katsuhaa/racechrono-diy-esp32/(commit log)

2026-09-05 Added Abarth 595 build manual (Japanese, Rev.1.6) under docs/
    Adds the step-by-step build manual for the Abarth 595 Series 4 variant of this adapter: Freenove ESP32-WROOM-32E board, SN65HVD230 transceiver with TXD left open (receive-only), MP1584EN 5 V buck fed from OBD pin 16, J1962 plug, known Fiat 500 (312) CAN-ID candidates, and Arduino IDE library versions (NimBLE-Arduino 1.4.3 pinned).
    Abarth 595 Series 4 向けの製作手順書（日本語、Rev.1.6）を docs/ に追加。Freenove ESP32-WROOM-32E、SN65HVD230（TXD オープンで受信専用）、OBD 16 番ピンから給電する MP1584EN 5 V 降圧、J1962 プラグ、Fiat 500 (312) 系の既知 CAN ID 候補、Arduino IDE の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
2026-09-06 Add config.h for the Abarth 595 on a classic ESP32-WROOM board
    Receive-only configuration: RX on GPIO 4, TX_PIN 5 left unwired,
    LOG_LEVEL_DEBUG so the 10-second frame counters serve as the on-device
    receive check, default rate 2 Hz, Fiat 500 (312) candidate CAN IDs
    listed as commented cases.
    Abarth 595 / 無印 ESP32-WROOM 用の config.h を追加。
    受信専用の設定: RX は GPIO 4、TX_PIN 5 は未配線、10 秒ごとの受信件数を
    実機での受信確認に使うため LOG_LEVEL_DEBUG、既定レート 2 Hz、
    Fiat 500（312）系の候補 CAN ID をコメントアウトで記載。
    Claude-Session: https://claude.ai/cod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
2026-09-06 Update build manual to Rev.1.7 (silkscreen pin names, figures, OBDLink method)
    Chapter 5 rewritten with the pin names printed on the boards (Freenove
    4 / 5 / 3.3V / 5V / GND), new figures for the Freenove pinout, the J1962
    plug and the wiring, a 9-wire table including MP1584EN OUT- to GND.
    Sniffer firmware appendix removed; CAN ID discovery now uses the
    OBDLink EX (STN commands) with an optional PC-side log script.
    config.h section synced with the repository file.
    製作手順書を Rev.1.7 に更新。
    5 章を基板のシルク表記（Freenove の 4 / 5 / 3.3V / 5V / GND）で書き直し、
    Freenove ピン配置図・J1962 ピン配置図・配線図を追加、
    MP1584EN OUT- から GND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
2026-09-06 Keep BLE controller memory on arduino-esp32 3.3.x (fixes boot loop)
    arduino-esp32 3.3.x releases the BLE controller memory during boot unless
    a BLE library claims it. NimBLE-Arduino 1.4.x predates that hook, so on a
    classic ESP32 esp_bt_controller_init() failed with ESP_ERR_INVALID_STATE
    and the board rebooted in a loop. Include esp32-hal-alloc-ble-mem.h
    (guarded for older cores) to claim the memory. Verified on the Freenove
    ESP32-WROOM board: BLE starts and RaceChrono connects.
    arduino-esp32 3.3.x では BLE ライブラリが宣言しない限り起動時に BLE 用
    メモリが解放されるため、NimBLE-Arduino 1.4.x では無印 ESP32 で
    esp_bt_controller_init() が ESP_ERR_INVALID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
    [racechrono-diy-esp32.ino]
2026-09-06 Add .gitignore for macOS metadata and local CAD files
    Ignore .DS_Store and the cad/ folder (FreeCAD case design kept locally).
    .DS_Store と cad/（ローカルの FreeCAD 筐体データ）を無視対象に追加。
    Claude-Session: https://claude.ai/code/session_01LZ2jKX8Gr4X3hKiqHrHCU5
2026-09-07 Confirm Abarth 595 CAN IDs, wire D to GPIO 5, add monitor and self-test tools, manual Rev.1.8
    config.h: getUpdateRateHz lists the IDs confirmed in the car on
    2026-09-07 (RPM and pedal 0x0618A001, steering 0x0030A002, speed
    0x0210A006, wheel speeds 0x0218A006, brake switch 0x0810A000, brake
    pressure 0x0010A006, clutch 0x0628A001). TX_PIN comment: D is wired to
    GPIO 5 because these transceiver modules do not receive with D open;
    listen-only keeps it recessive.
    tools/can_monitor: listen-only in-car monitor with baseline range
    learning, EVENT lines for changed bytes, MARK annotations and a pin
    diagnosis when no frames arrive.
    tools/twai_selftest: bench self-test (DAC receiver test, loopback,
    ESP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
2026-09-12 Add shift indicator LED bar driven from CAN RPM
    Drive a 24-LED WS2812B bar from the RPM already on the bus, using the esp32 core RMT HAL so no external LED library is needed.
    RPM is read directly from CAN ID 0x0618A001 bytes 2-3 in taskGetTwaiMessages rather than through pidMap, which is emptied when RaceChrono disconnects and would leave the bar dead with no phone connected.
    taskUpdateShiftLed refreshes at 20 ms, pinned to the TWAI core at priority 1 so it can never delay the TWAI or BLE tasks.
    Scale: LED 1 is always orange. LED 2 to LED 24 form the bar at 1000, 1700, 2400, then 200 rpm per LED up to 6400. Each LED keeps its own colour (gray, blue, green, yellow) so the bar builds up as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
2026-09-16 Make the shift indicator RPM timestamp atomic across tasks
    esp_timer_get_time() returns int64_t and a 64-bit store is not atomic on this CPU, so taskUpdateShiftLed could read a half-updated timestamp written by taskGetTwaiMessages and blank the bar for one 20 ms frame. Keep only the low 32 bits; unsigned wraparound keeps the difference correct across the rollover.
    シフトインジケータの回転数タイムスタンプをタスク間で不可分にする。esp_timer_get_time() は int64_t を返すが、この CPU では 64 ビットの書き込みが不可分ではない。taskGetTwaiMessages が書いている途中の値を taskUpdateShiftLed が読み、20ms の 1 フレームだ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
    [racechrono-diy-esp32.ino]
2026-09-16 Add SHIFT_REVERSE to flip the bar for either strip orientation
    The strip will sit the other way round in the case, so LED#1 lands at the far end instead of the DIN end. Map the logical position to the physical LED in shiftSetPixel only; the render logic keeps counting LED#1 as the low-rpm end. Set SHIFT_REVERSE back to 0 if the finished case turns out the other way.
    テープの向きを入れ替えられるように SHIFT_REVERSE を追加する。筐体では逆向きに入る見込みで、LED#1 が DIN 側ではなく反対端に来る。論理位置から実 LED への変換は shiftSetPixel だけで行い、描画側は LED#1 を低回転側として数えたままにする。実物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
    [config.h, racechrono-diy-esp32.ino]
2026-09-25 Fix CAN rate limiter disabled after 71.6 minutes of uptime
    PidExtra::lastMessageTime is uint32_t but was compared against the 64-bit esp_timer_get_time(). Once the ESP32 had been running for 2^32 us (71.6 min) the difference never fell below the update interval, so every CAN frame was forwarded and the per-ID limits in getUpdateRateHz() stopped working. A 2026-09-14 session showed every channel at 80-90 Hz instead of 5-20 Hz. Do the subtraction in 32-bit arithmetic so it stays correct across the wrap.
    起動から 71.6 分を過ぎると CAN のレート制限が効かなくなる不具合を修正。PidExtra::lastMessageTime は uint32_t なのに 64 bit の esp_timer_get_time() と引き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
    [racechrono-diy-esp32.ino]
2026-09-27 Port the settled shift bar display to the CAN firmware, add a power-on illumination and a CAN debug dump
    The shift indicator in this firmware still had the 2026-09-12 rules (per-LED fixed colours, one direction only, flash from 5800). Bring it in line with the display spec settled on 2026-09-17 and already proven on the bench in led_selftest.ino, driven by the RPM read from CAN ID 0x0618A001.
    Three patterns cycled by the BOOT button (GPIO 0) and kept in NVS (namespace shiftled): bar from the strip start, bar from the far end, mirror from both ends. White LEDs (pattern + 1) confirm a change and the restore at boot; red means the NVS write failed. SHIFT_REVERSE is removed, pattern 0/1 replace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
    [config.h, racechrono-diy-esp32.ino]
2026-09-30 Fix the shift bar staying dark: CAN RPM bytes are rpm as is, divisor 1
    SHIFT_RPM_DIVISOR was a placeholder of 4. The in-car log of 2026-09-07 (manual Rev.1.8, 3-1) and the RaceChrono equation bytesToUint(raw, 2, 2) both show that bytes 2-3 of 0x0618A001 are the rpm itself, so with 4 the bar treated 6400 rpm as 1600 and never lit. Set the divisor to 1, drop the unconfirmed note from the can_dump rpm line and decode the steering angle there as (raw20 - 7400) x 0.1 deg per the manual.
    シフトバーが点かない不具合の修正。SHIFT_RPM_DIVISOR は仮置きの 4 だったが、2026-09-07 の実車ログ（手順書 Rev.1.8 の 3-1）と RaceChrono の式 bytesToUint(raw, 2, 2) のと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
    [config.h, racechrono-diy-esp32.ino]
2026-10-04 Show the rpm expected 150 ms ahead while revving up
    The engine climbs faster than a step on the bar can be seen and acted on. While the rpm is rising, show the value expected SHIFT_LEAD_MS (150 ms) from now: the bus value plus the rise rate measured over the last SHIFT_LEAD_WINDOW_MS (100 ms) of RPM frames, times the lead plus the age of the last frame. The rate is taken against the oldest frame in the window so frame-to-frame jitter averages out, the amount added is capped at SHIFT_LEAD_MAX_RPM (600) so one bad frame cannot fill the bar, and falling or steady rpm is shown as is. Length, colour, flash and red all use the shown value. SHIFT_LEAD_MS 0 turns it off. The 10 s DEBUG line now prin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
    [config.h, racechrono-diy-esp32.ino]
2026-10-05 Remove the rpm look-ahead: it breaks the fixed rpm per LED
    Tried in the car: with the bar showing a predicted value, each LED no longer stands for a fixed rpm and the spacing became hard to read. Go back to showing the bus rpm as is. This restores config.h and the sketch to the state of d2709d8.
    回転数の先読みを削除する。実車で試したところ、予想値を表示するとLEDごとの回転数が固定でなくなり、間隔がつかみにくくなった。バスの回転数をそのまま表示する形に戻す。config.h とスケッチは d2709d8 の状態と同一。
    Claude-Session: https://claude.ai/code/sess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
    [config.h, racechrono-diy-esp32.ino]
2026-10-06 Restart once after a pattern change so the illumination shows it
    At idle the bar is dark, so a new pattern could not be seen until the next power-on. After the BOOT button has changed the pattern and the NVS write has been read back, restart the board once: the power-on illumination plays again and its rpm sweep shows the new pattern. The restart waits for the button to be released, since a button still down at boot would be read as another press; it is skipped if the button is held longer than SHIFT_PATTERN_RESET_WAIT_MS (5 s) or the NVS write failed (red). The button state at boot is now taken from the pin, so a button already down is not a press. BLE drops once during the restart. SHIFT_P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
    [config.h, racechrono-diy-esp32.ino]
2026-10-07 Fade colour changes over 400 rpm, drop the pattern number, show a new pattern at once with a slow sweep
    The whole bar switched colour at once at 3000, 4000, 5400 and 6200 rpm, which felt abrupt. In the SHIFT_COLOR_BLEND_RPM (400, two bar LEDs) just below each of these points, blend linearly from the previous colour into the next one, reaching it exactly at the point. The colour still depends on the rpm only, and 0 restores the instant change (checked over every rpm from 0 to 8000). With 400 the yellow-to-red fade starts at 5800, so the full bar warms toward orange before it starts flashing at 6000.
    The white LEDs that showed the pattern number are removed, at a press and at boot: the patter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
2026-10-11 Light the bar at full brightness from green up and flash it from 5800 rpm
    Red flashing was easy to notice while driving, the display before it was not. The lit bar from green up (green, yellow, the yellow-to-red fade and red, flashing included) is now drawn at SHIFT_GREEN_UP_BRIGHTNESS (255) instead of SHIFT_MASTER_BRIGHTNESS (128). In the blue-to-green fade (3600 to 4000 rpm) the level rises from 128 to 255 together with the colour, so there is no sudden jump. Gray, blue, the orange ends and the power-on rainbow and white flash keep the master level. Setting SHIFT_GREEN_UP_BRIGHTNESS to 128 gives exactly the old output (checked byte for byte for all three patterns over every rpm from 0 to 8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
